batsWTR/Nikon_remote/README.md

# Nikon_remote
An infra red remote for Nikon D50 type ML-L3
