batsWTR/Nikon_remote/attinyD50.odt

Attiny Nikon D50 remote

## PWM a 38Khz avec le Timer1 :

L'Attiny possède 2 timers, timer0 et timer1.

Le PWM du timer 1 est disponible sur les broches PB4 et PB3, il faut activer la pin en sortie.

Ensuite il faut activer l'horloge et/ou le prescaler dans TCCR1 puis activer le PWM et le niveau de sortie LOW /HIGH dans le registre GTCCR. OCR1B sert de declencheur du PWM et OCR1C sert a limiter le comptage.

Oscillateur de l'Attiny est a 1Mhz soit une période de 1us. Le Timer1 étant sur 8 bits, il débordera a 256us. En configurant OCRB a 128, on aura un signal carré de période 256us avec HIGH=128us et LOW=128us.

En configurant OCRC1 à 26, le compteur repartira a 0 non pas a 255us mais a 26us et en configurant OCR1B a 13, on obtient notre fréquence à 38Khz.

Avant tout, il faut inclure les en tetes suivantes :

#include <avr/io.h> //Pour les entrees sorties

#include <util/delay.h> // Pour les delays

#include <avr/interrupt.h> //Pour gerer les enterruptions

ensuite, dans le main :

cli() ; //desactive les interruptions, vraiment au debut ?

TCCR1 = 0 ; //Timer counter 1 control register : config compteur 1

TCCR1 = 1<<CS10 ; //Compte a la freq CPU, pas de prescaler

GTCCR = 1<<PWM1B | 1<<COM1B0; // pwm actif, toggle OC1B

OCR1C = 26; // le compteur compte jusque 152

OCR1B = 13; // déclenchement a 128

deébordement

sources :

http://www.engblaze.com/microcontroller-tutorial-avr-and-arduino-timer-interrupts/

http://blog.cicatrice.eu/40
