batsWTR/Nikon_remote/D50_remote_kicad/D50_remote_kicad.kicad_pcb

## KiCad design D50_remote_kicad/D50_remote_kicad.kicad_pcb (2016-05-03)

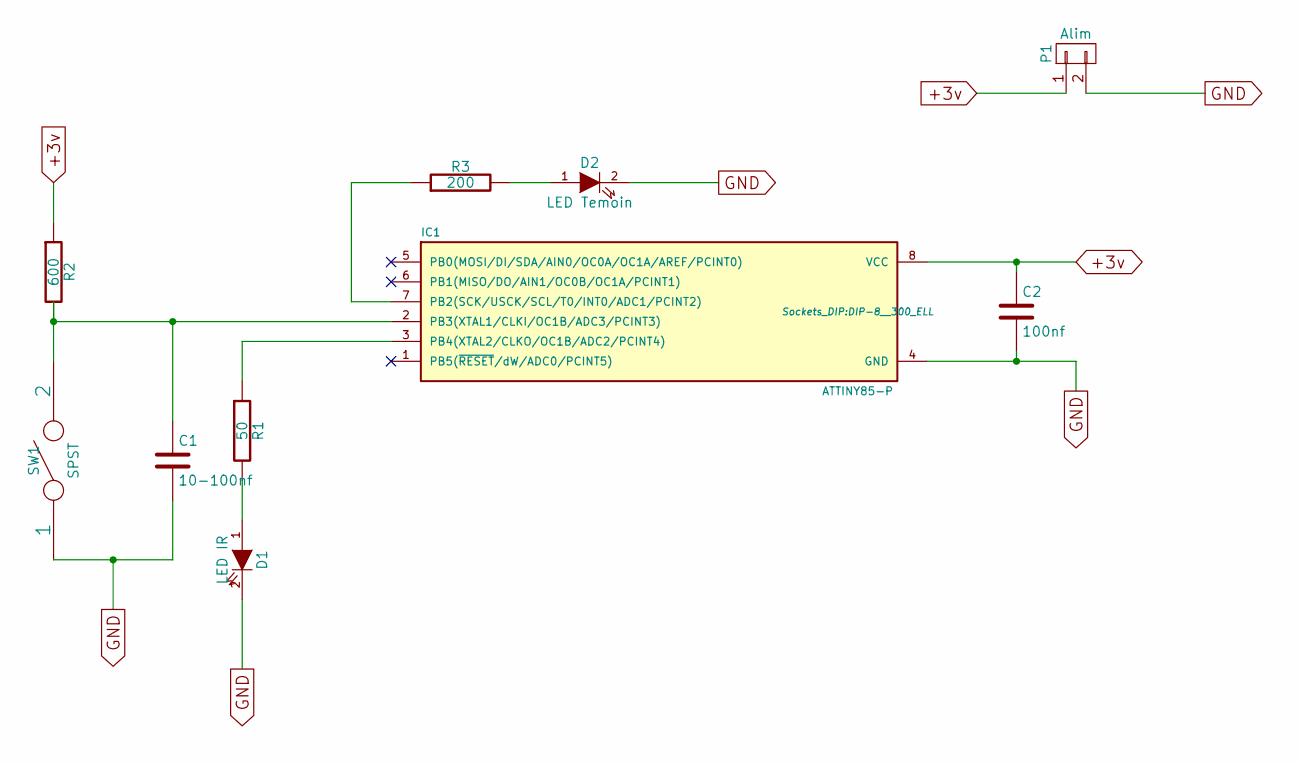
[picture p2: schematic D50_remote_kicad.sch]

Parts:
C1: 10-100nf; C1
C2: 100nf; C1
D1: LED IR; LED-3MM
D2: LED Temoin; LED-3MM
IC1: ATTINY85-P; DIP-8__300_ELL
P1: Alim; CR2032H
R1: 50; R3
R2: 600; R3
R3: 200; R3
SW1: SPST; push_mini

Connections:
+3v: C2.1, IC1.8 (VCC), P1.1, R2.1
GND: C1.2, C2.2, D1.2 (K), D2.2 (K), IC1.4 (GND), P1.2, SW1.1
unnamed: C1.1, IC1.2 (PB3(XTAL1/CLKI/OC1B/ADC3/PCINT3)), R2.2, SW1.2
unnamed: D1.1 (A), R1.2
unnamed: D2.1 (A), R3.2
unnamed: IC1.3 (PB4(XTAL2/CLKO/OC1B/ADC2/PCINT4)), R1.1
unnamed: IC1.7 (PB2(SCK/USCK/SCL/T0/INT0/ADC1/PCINT2)), R3.1

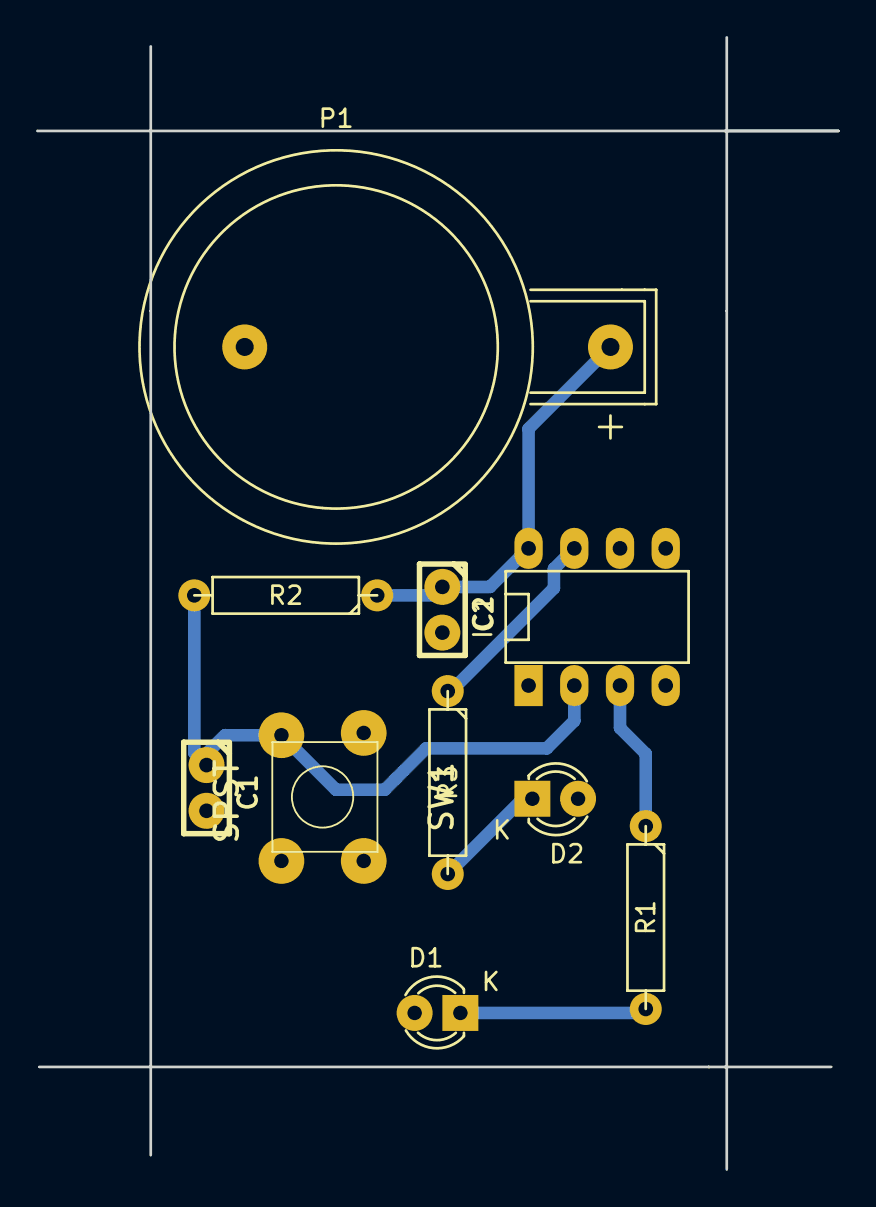
[picture p3: board D50_remote_kicad.kicad_pcb from above]

Board: 2 copper layers, 32.0 x 52.0 mm, 10 parts (0 on the bottom side), 7 nets.
